Anuragsahoo-IIITG/RC-Warship/assets/ArduinoNano.jpeg

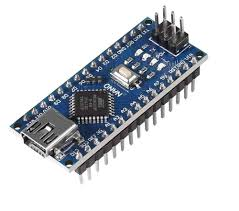
assets/ArduinoNano.jpeg
