Anuragsahoo-IIITG/RC-Warship/assets/Labelledpillarimage.JPG

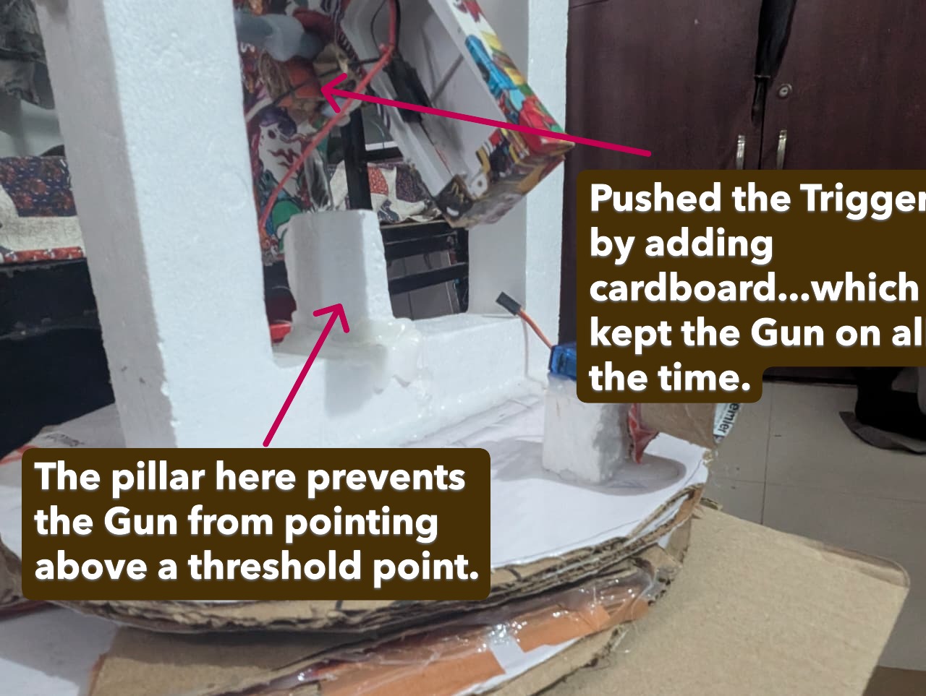
assets/Labelledpillarimage.JPG
