Anuragsahoo-IIITG/RC-Warship/IMG-20250209-WA0003.jpg

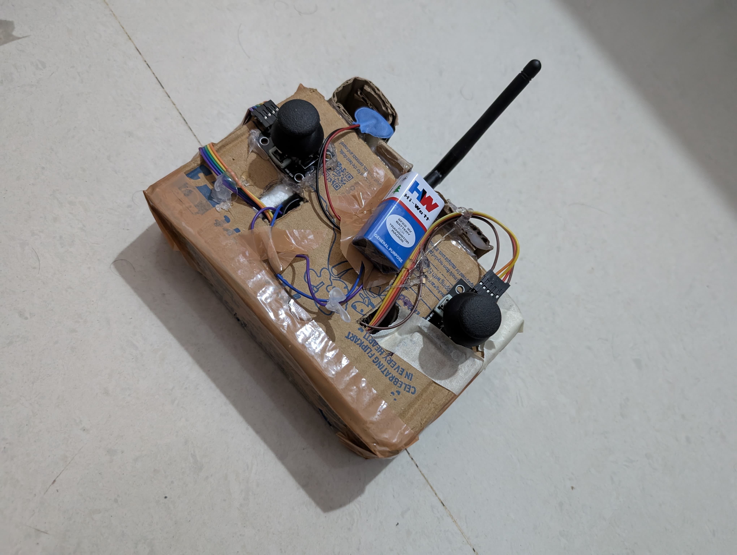
IMG-20250209-WA0003.jpg
