Anuragsahoo-IIITG/RC-Warship/IMG-20250209-WA0004.jpg

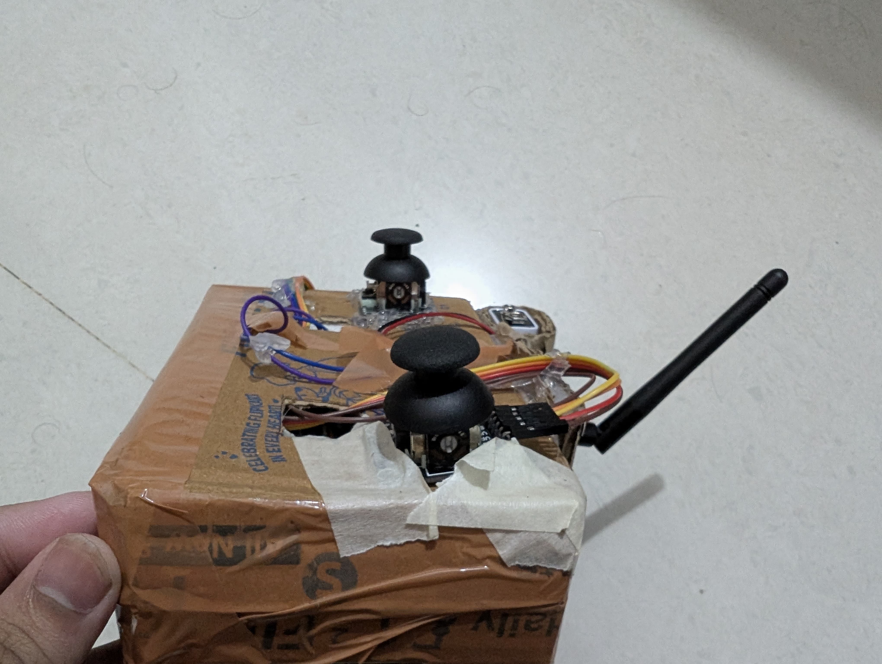
IMG-20250209-WA0004.jpg
