Anuragsahoo-IIITG/RC-Warship/IMG-20250209-WA0005.jpg

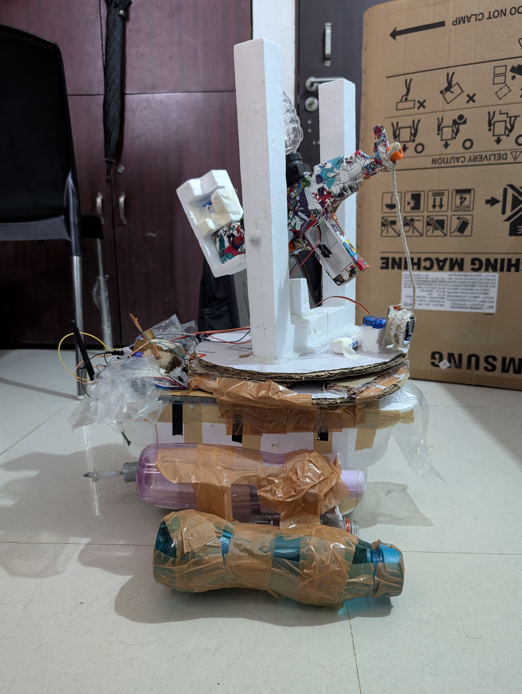
IMG-20250209-WA0005.jpg
