Anuragsahoo-IIITG/RC-Warship/IMG-20250209-WA0006.jpg

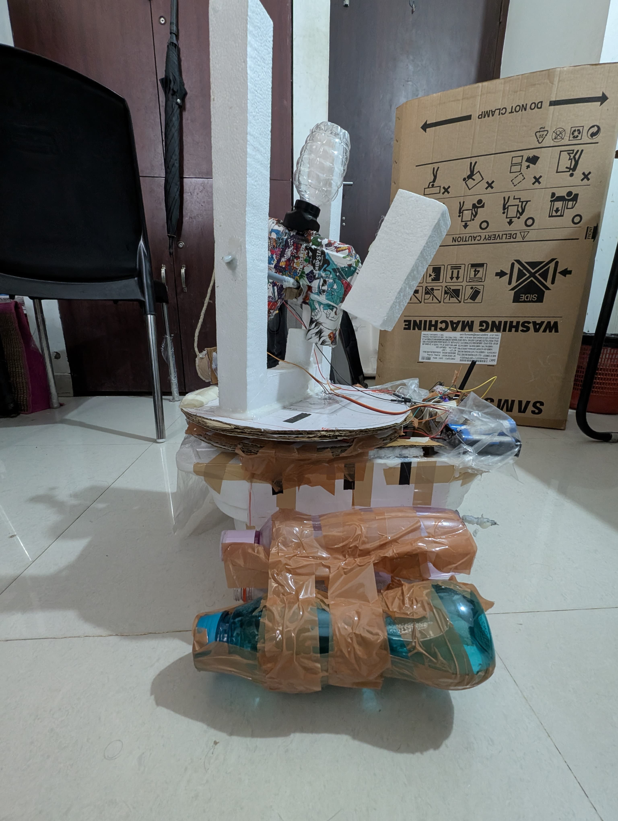
IMG-20250209-WA0006.jpg
