Anuragsahoo-IIITG/RC-Warship/IMG-20250209-WA0008.jpg

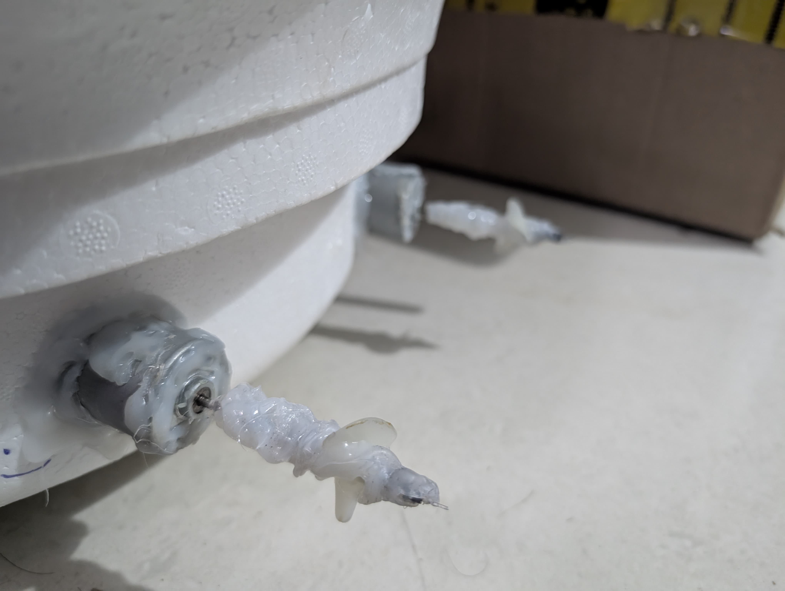
IMG-20250209-WA0008.jpg
