Anuragsahoo-IIITG/RC-Warship/IMG-20250209-WA0010.jpg

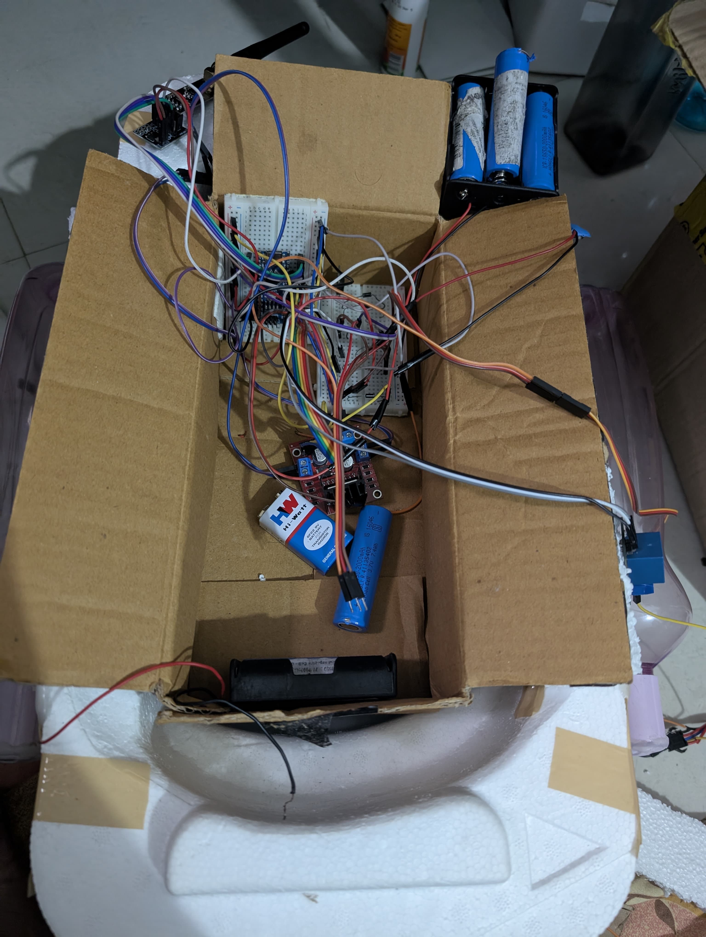
IMG-20250209-WA0010.jpg
